jeremiasvasqac-art/furnace-pid-controller-ai/hardware/block_diagram.png

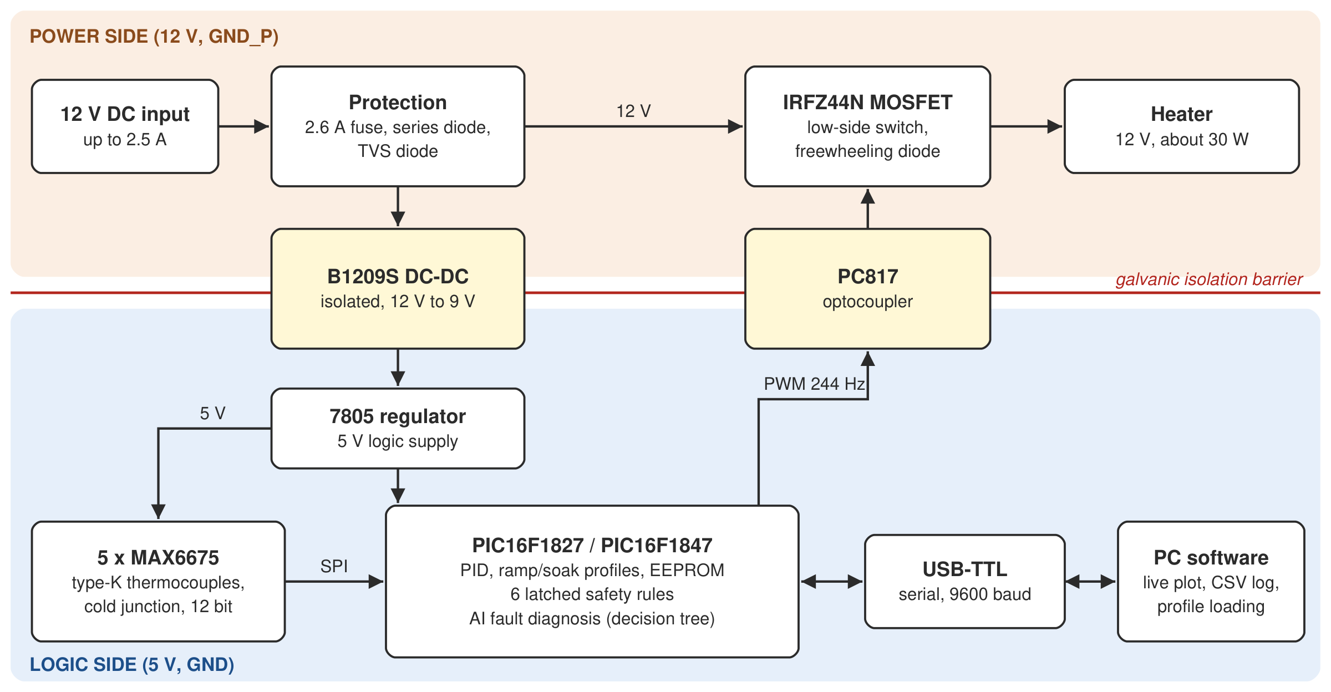
hardware/block_diagram.png
