jeremiasvasqac-art/furnace-pid-controller-ai/hardware/bill_of_materials.csv

Category | Quantity | References | Value | Stock Code | Unit Cost
Capacitors | 2 | C1,C6 | 10uF
Capacitors | 4 | C2,C5,C8,C10 | 100nF
Capacitors | 2 | C3-C4 | 22pF
Capacitors | 1 | C7 | 470uF
Capacitors | 1 | C9 | 4.7uF
Resistors | 1 | R1 | 220
Resistors | 1 | R2 | 100
Resistors | 1 | R3 | 4.7k
Resistors | 2 | R4,R9 | 10k
Resistors | 1 | R5 | 1k
Integrated Circuits | 1 | U1 | PC817
Integrated Circuits | 1 | U2 | PIC16F1827
Integrated Circuits | 1 | U3 | 7805
Integrated Circuits | 1 | U4 | B1209S
Transistors | 1 | Q1 | IRFZ44N
Diodes | 2 | D1,D3 | SB540
Diodes | 1 | D2 | SMBJ15A | Digikey SMBJ15ALFTR-ND
Miscellaneous | 1 | FU1 | 2.6A
Miscellaneous | 1 | J3 | CARGA
Miscellaneous | 1 | J4 | TP_GATE
Miscellaneous | 1 | J5 | TP_SW
Miscellaneous | 1 | J6 | TBLOCK-I2
Miscellaneous | 1 | J7 | TP_GND
Miscellaneous | 1 | J8 | TP_12V
Miscellaneous | 6 | J9-J13,J15 ICSP | CONN-SIL5
Miscellaneous | 1 | J14 | CONN-SIL4
Miscellaneous | 1 | X1 | 4Mhz | AR2348
