jeremiasvasqac-art/furnace-pid-controller-ai/(list of files, drawings)

Other design files:
hardware/PCB_horno_industrial_revD.pdsprj
