jeremiasvasqac-art/furnace-pid-controller-ai/(commit log)

2026-11-07 PID furnace controller board with on-board AI fault diagnosis (AI-SED 2026)
    Firmware v2 for PIC16F1827/PIC16F1847, decision-tree fault diagnosis,
    hardware-in-the-loop test bench, AI training pipeline, PC tool and the
    Proteus rev D project.
    [PCB_horno_industrial_revD.pdsprj, bill_of_materials.csv]
2026-11-07 Add Gerber and drill files for PCB revision D
2026-11-08 Point U2's Program File at the bundled Proteus hex
    U2 now loads horno_proteus.hex by bare name, so Proteus resolves it next
    to the project file instead of a VSM Studio temp folder on one machine.
    [PCB_horno_industrial_revD.pdsprj]
2026-11-08 Remove outdated embedded firmware from the Proteus project
    The project still carried the rev C PIC16F628A source as a VSM Studio
    firmware project. U2 loads horno_proteus.hex, so the stale source only
    caused confusion and an XC8 build attempt on machines without it.
    [PCB_horno_industrial_revD.pdsprj]
